tmaslon/Ammeter/Ammeter.pdf

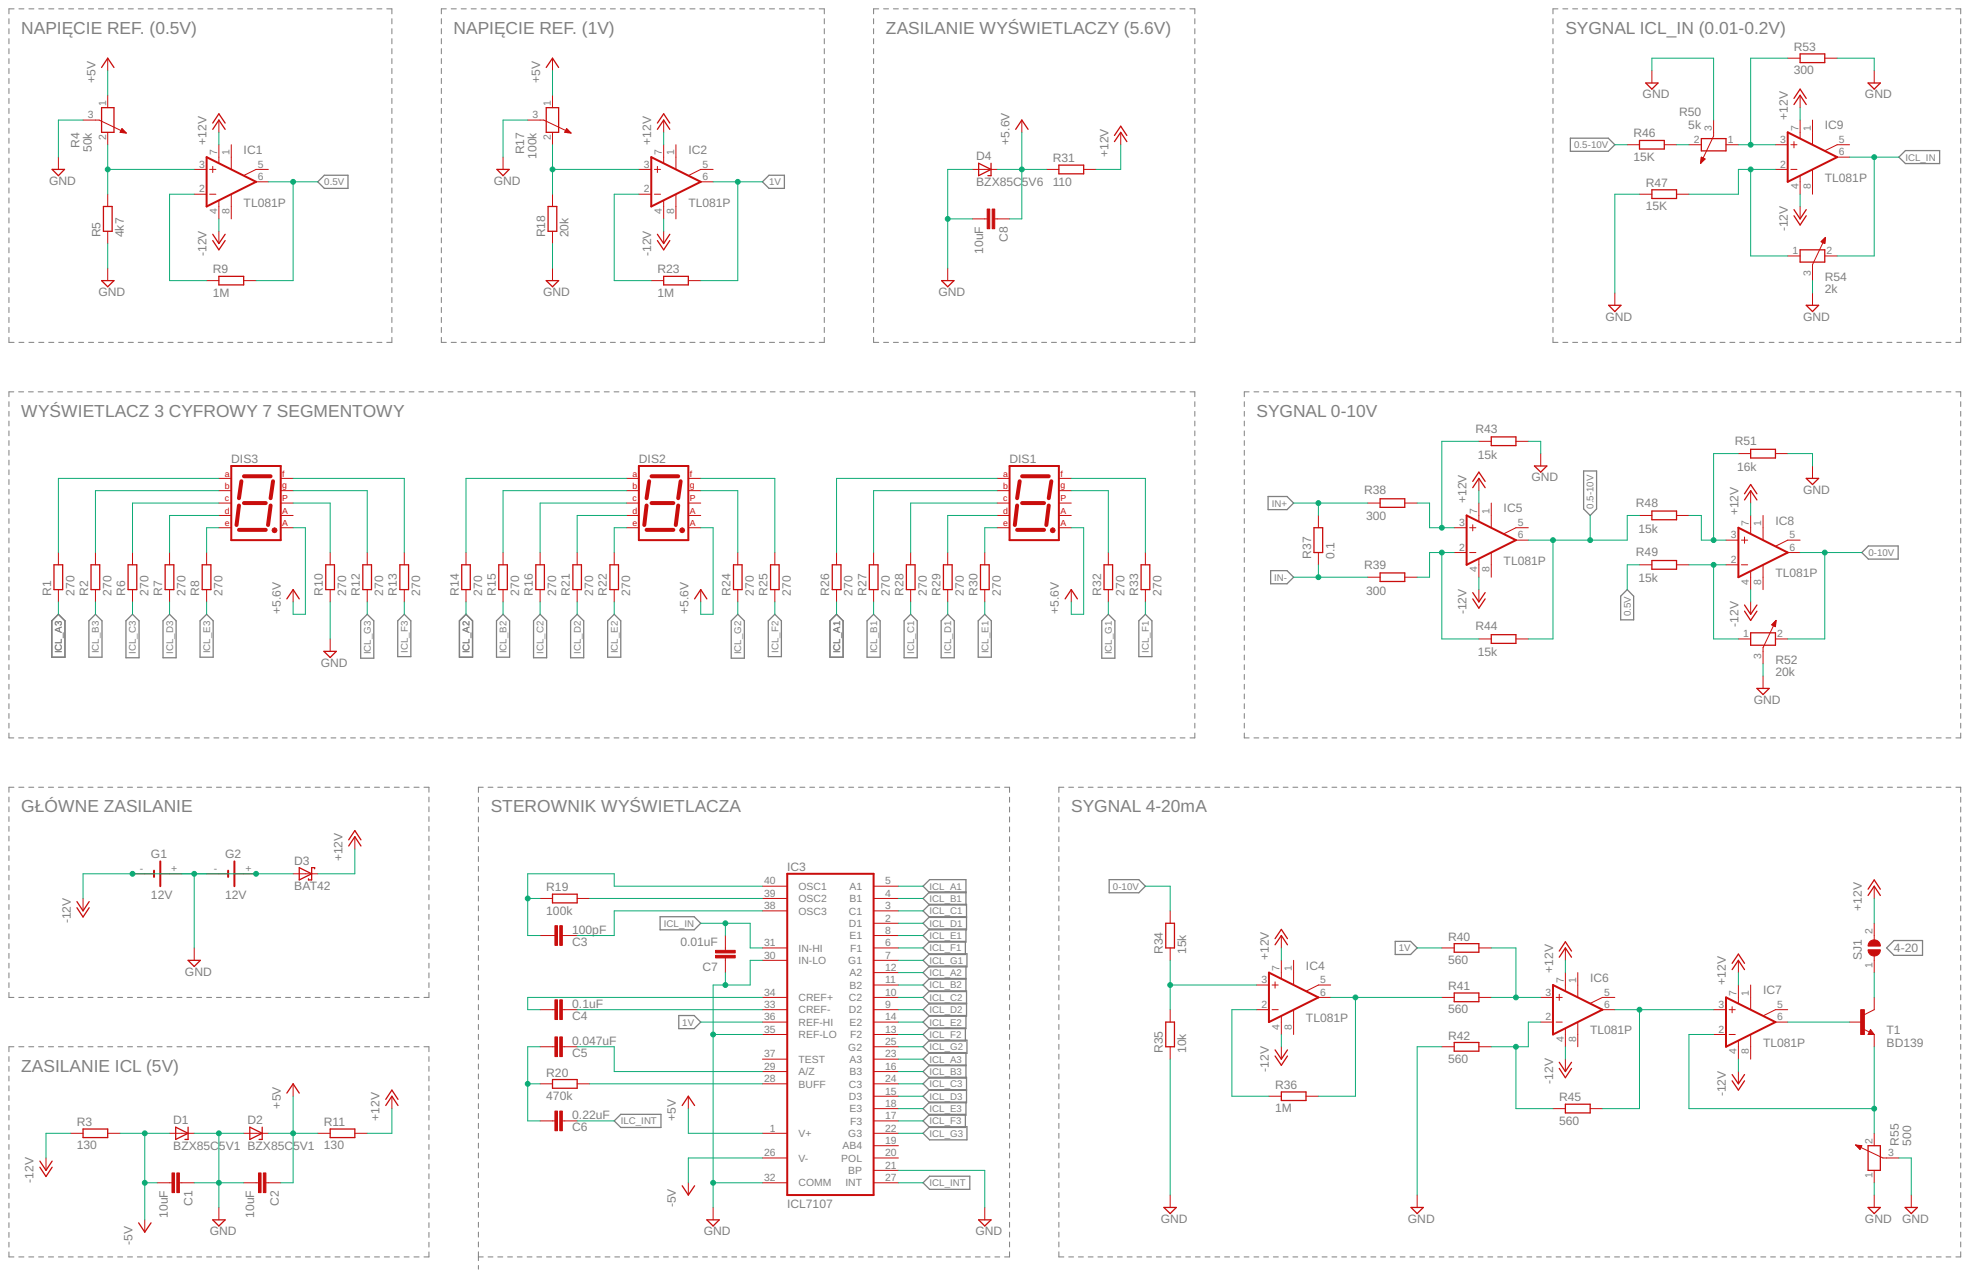
[picture p12: page 1]
