tmaslon/Ammeter/schemat.pdf

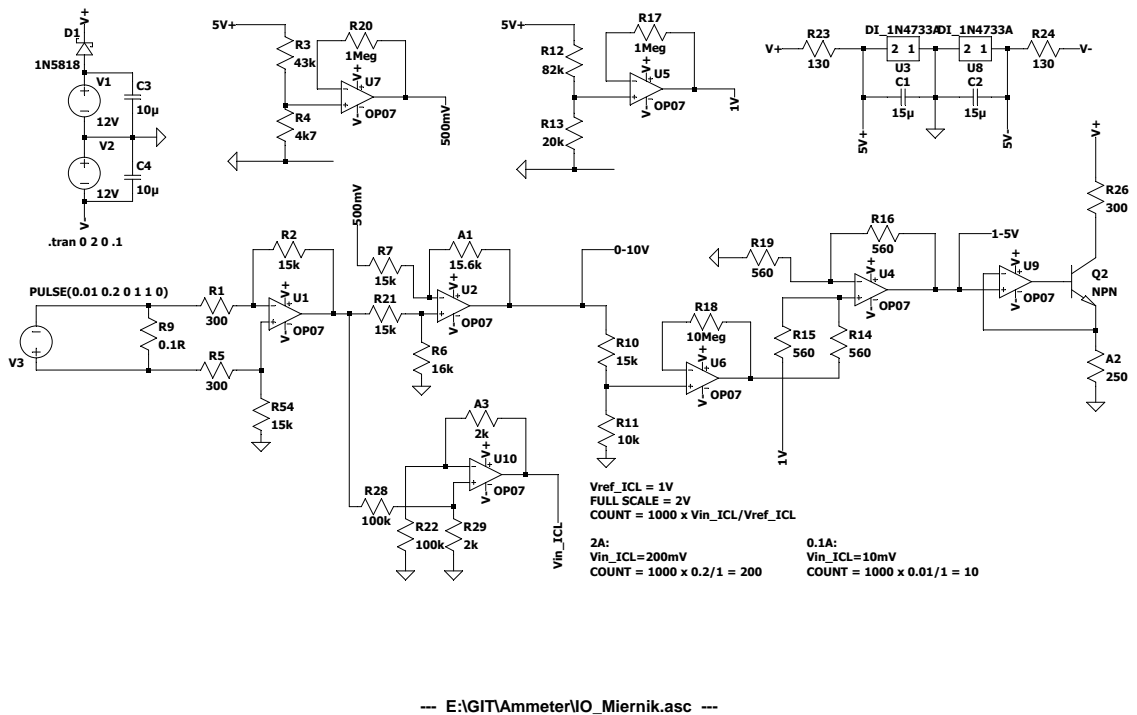
[picture p13: page 1]
