tmaslon/Ammeter/IO_Miernik.asc

A1: res; 15.6k
A2: res; 250
A3: res; 2k
C1: cap; 15µ
C2: cap; 15µ
C3: cap; 10µ
C4: cap; 10µ
D1: schottky; 1N5818
Q2: npn
R1: res; 300
R2: res; 15k
R3: res; 43k
R4: res; 4k7
R5: res; 300
R6: res; 16k
R7: res; 15k
R9: res; 0.1R
R10: res; 15k
R11: res; 10k
R12: res; 82k
R13: res; 20k
R14: res; 560
R15: res; 560
R16: res; 560
R17: res; 1Meg
R18: res; 10Meg
R19: res; 560
R20: res; 1Meg
R21: res; 15k
R22: res; 100k
R23: res; 130
R24: res; 130
R26: res; 300
R28: res; 100k
R29: res; 2k
R54: res; 15k
U1: OP07
U2: OP07
U3: DI_1N4733A
U4: OP07
U5: OP07
U6: OP07
U7: OP07
U8: DI_1N4733A
U9: OP07
U10: OP07
V1: voltage; 12V
V2: voltage; 12V
V3: voltage; PULSE(0.01 0.2 0 1 1 0)
Named nets: 0, V+, V-, 5V+, 0-10V, 1V, 1-5V, 500mV, 5V-, Vin_ICL
.tran 0 2 0 .1
Vref_ICL = 1V
FULL SCALE = 2V
COUNT = 1000 x Vin_ICL/Vref_ICL
 
2A:
Vin_ICL=200mV
COUNT = 1000 x 0.2/1 = 200
0.1A:
Vin_ICL=10mV
COUNT = 1000 x 0.01/1 = 10
