tmaslon/Ammeter/Ammeter.sch

## EAGLE design Ammeter.sch (2019-01-29)

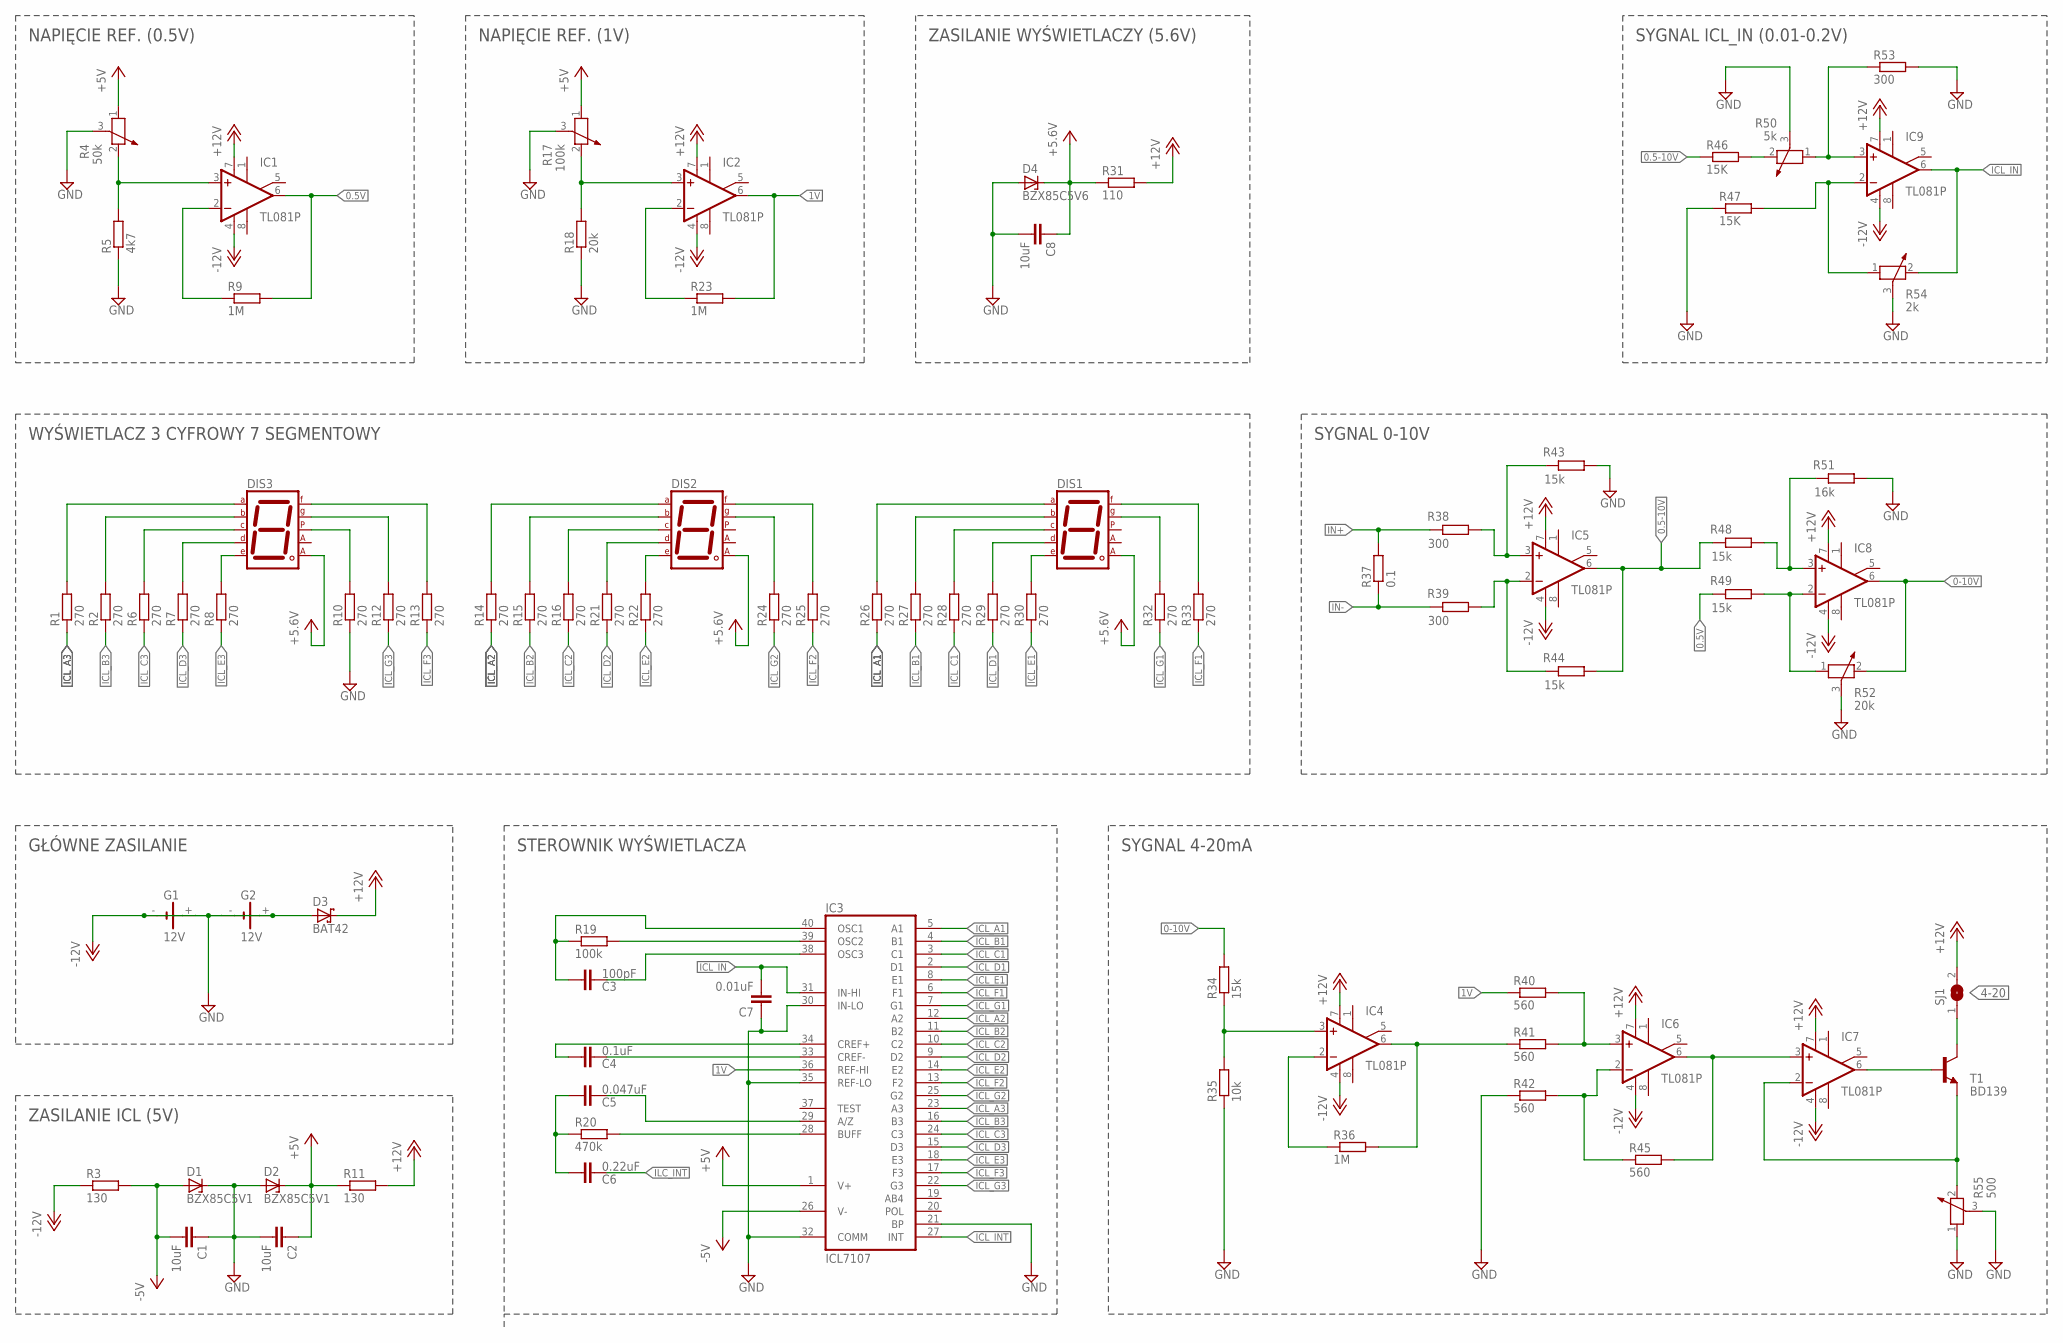
[picture p14: schematic Ammeter.sch]

Parts:
C1, C2, C8: 10uF; C025-024X044
C3: 100pF; C025-024X044
C4: 0.1uF; C025-024X044
C5: 0.047uF; C025-024X044
C6: 0.22uF; C025-024X044
C7: 0.01uF; C025-024X044
D1, D2: BZX85C5V1; DO41Z10
D3: BAT42; DO35-10
D4: BZX85C5V6; DO41Z10
DIS1, DIS2, DIS3: 7SEG-CA; 7SEG-13
G1, G2: 12V; CH291-1220LF
IC1, IC2, IC4, IC5, IC6, IC7, IC8, IC9: TL081P; DIL08
IC3: ICL7107; DIL40
R1, R2, R6, R7, R8, R10, R12, R13, R14, R15, R16, R21, R22, R24, R25, R26, R27, R28, R29, R30, R32, R33: 270; 0204/7
R3, R11: 130; 0204/7
R4: 50k; PT-SPIN
R5: 4k7; 0204/7
R9, R23, R36: 1M; 0204/7
R17: 100k; PT-SPIN
R18: 20k; 0204/7
R19: 100k; 0204/7
R20: 470k; 0204/7
R31: 110; 0204/7
R34, R43, R44, R48, R49: 15k; 0204/7
R35: 10k; 0204/7
R37: 0.1; 0204/7
R38, R39, R53: 300; 0204/7
R40, R41, R42, R45: 560; 0204/7
R46, R47: 15K; 0204/7
R50: 5k; PT-SPIN
R51: 16k; 0204/7
R52: 20k; PT-SPIN
R54: 2k; PT-SPIN
R55: 500; PT-SPIN
SJ1: SJ
T1: BD139; TO126

Connections:
0-10V: IC8.6 (OUT), R34.2, R52.2
0.5-10V: IC5.6 (OUT), R44.1, R46.1, R48.2
0.5V: IC1.6 (OUT), R9.2, R49.2
1V: IC2.6 (OUT), IC3.36 (REF-HI), R23.2, R40.1
4-20: SJ1.1, T1.2 (C)
+5V: C2.1, C8.1, D2.C, D4.C, DIS1.8 (CA2), DIS2.8 (CA2), DIS3.8 (CA2), IC3.1 (V+), R4.1, R11.1, R17.1, R31.1
+12V: D3.C, IC1.7 (V+), IC2.7 (V+), IC4.7 (V+), IC5.7 (V+), IC6.7 (V+), IC7.7 (V+), IC8.7 (V+), IC9.7 (V+), R11.2, R31.2, SJ1.2
-5V: C1.2, D1.A, IC3.26 (V-), R3.2
-12V: D3.A, G1.-, G2.+, IC1.4 (V-), IC2.4 (V-), IC4.4 (V-), IC5.4 (V-), IC6.4 (V-), IC7.4 (V-), IC8.4 (V-), IC9.4 (V-), R3.1
GND: C1.1, C2.2, C7.1, C8.2, D1.C, D2.A, D4.A, G1.+, G2.-, IC3.21 (BP), IC3.30 (IN-LO), IC3.32 (COMM), IC3.35 (REF-LO), R4.3, R5.1, R10.1, R17.3, R18.1, R35.1, R42.1, R43.1, R47.1, R50.3, R51.1, R52.3, R53.2, R54.3, R55.1, R55.3
ICL_A1: IC3.5 (A1), R26.1
ICL_A2: IC3.12 (A2), R14.1
ICL_A3: IC3.23 (A3), R1.1
ICL_B1: IC3.4 (B1), R27.1
ICL_B2: IC3.11 (B2), R15.1
ICL_B3: IC3.16 (B3), R2.1
ICL_C1: IC3.3 (C1), R28.1
ICL_C2: IC3.10 (C2), R16.1
ICL_C3: IC3.24 (C3), R6.1
ICL_D1: IC3.2 (D1), R29.1
ICL_D2: IC3.9 (D2), R21.1
ICL_D3: IC3.15 (D3), R7.1
ICL_E1: IC3.8 (E1), R30.1
ICL_E2: IC3.14 (E2), R22.1
ICL_E3: IC3.18 (E3), R8.1
ICL_F1: IC3.6 (F1), R33.1
ICL_F2: IC3.13 (F2), R25.1
ICL_F3: IC3.17 (F3), R13.1
ICL_G1: IC3.7 (G1), R32.1
ICL_G2: IC3.25 (G2), R24.1
ICL_G3: IC3.22 (G3), R12.1
ICL_IN: C7.2, IC3.31 (IN-HI), IC9.6 (OUT), R54.2
ICL_INT: IC3.27 (INT)
ILC_INT: C6.1
IN+: R37.2, R38.2
IN-: R37.1, R39.2
unnamed: C3.2, IC3.40 (OSC1), R19.1
unnamed: IC3.39 (OSC2), R19.2
unnamed: C3.1, IC3.38 (OSC3)
unnamed: C4.2, IC3.34 (CREF+)
unnamed: DIS3.5 (DP), R10.2
unnamed: C4.1, IC3.33 (CREF-)
unnamed: IC1.2 (-IN), R9.1
unnamed: C5.1, IC3.29 (A/Z)
unnamed: IC3.28 (BUFF), R20.2
unnamed: C5.2, C6.2, R20.1
unnamed: IC2.2 (-IN), R23.1
unnamed: IC1.3 (+IN), R4.2, R5.2
unnamed: IC2.3 (+IN), R17.2, R18.2
unnamed: IC5.3 (+IN), R38.1, R43.2
unnamed: IC5.2 (-IN), R39.1, R44.2
unnamed: IC8.2 (-IN), R49.1, R52.1
unnamed: IC4.3 (+IN), R34.1, R35.2
unnamed: IC8.3 (+IN), R48.1, R51.2
unnamed: IC4.2 (-IN), R36.1
unnamed: IC4.6 (OUT), R36.2, R41.1
unnamed: IC6.3 (+IN), R40.2, R41.2
unnamed: IC7.6 (OUT), T1.3 (B)
unnamed: IC6.2 (-IN), R42.2, R45.1
unnamed: IC6.6 (OUT), IC7.3 (+IN), R45.2
unnamed: IC7.2 (-IN), R55.2, T1.1 (E)
unnamed: DIS1.7 (A), R26.2
unnamed: DIS1.6 (B), R27.2
unnamed: DIS1.4 (C), R28.2
unnamed: DIS1.2 (D), R29.2
unnamed: DIS1.1 (E), R30.2
unnamed: DIS1.9 (F), R33.2
unnamed: DIS2.7 (A), R14.2
unnamed: DIS1.10 (G), R32.2
unnamed: DIS2.2 (D), R21.2
unnamed: DIS2.6 (B), R15.2
unnamed: DIS2.4 (C), R16.2
unnamed: DIS2.1 (E), R22.2
unnamed: DIS2.9 (F), R25.2
unnamed: DIS2.10 (G), R24.2
unnamed: DIS3.7 (A), R1.2
unnamed: DIS3.2 (D), R7.2
unnamed: DIS3.6 (B), R2.2
unnamed: DIS3.4 (C), R6.2
unnamed: DIS3.1 (E), R8.2
unnamed: DIS3.9 (F), R13.2
unnamed: DIS3.10 (G), R12.2
unnamed: R46.2, R50.2
unnamed: IC9.3 (+IN), R50.1, R53.1
unnamed: IC9.2 (-IN), R47.2, R54.1

Notes on the sheet:
GŁÓWNE ZASILANIE
ZASILANIE ICL (5V)
SYGNAL 0-10V
SYGNAL 4-20mA
STEROWNIK WYŚWIETLACZA
WYŚWIETLACZ 3 CYFROWY 7 SEGMENTOWY
SYGNAL ICL_IN (0.01-0.2V)
ZASILANIE WYŚWIETLACZY (5.6V)
NAPIĘCIE REF. (0.5V)
NAPIĘCIE REF. (1V)
