tmaslon/Ammeter/(commit log)

2019-01-17 Adding diode voltage regulator and transistor
2019-01-19 Updating resistors' values, adding Vin_ICL
2019-01-22 Adding EAGLE lib - work in progress
    [Ammeter.sch]
2019-01-22 Lib: adding 0-10V signal
    [Ammeter.sch]
2019-01-22 Lib: Adding 4-20mA signal
    [Ammeter.sch]
2019-01-23 Lib: added ICL pins labels and displays
    [Ammeter.sch]
2019-01-24 Added ICL_IN signal, renumbered parts
    [Ammeter.sch]
2019-01-26 Added separate power supply for displays, updating parts' values
    [Ammeter.sch]
2019-01-27 Renumbering parts
    [Ammeter.sch]
2019-01-29 fixed errors in schematic and added BOM
    [Ammeter.sch, BOM.csv]
2019-01-29 hotfix (incorrect label in schematic)
    [Ammeter.sch]
2019-01-29 Updated documentation: added tests results and attachments
2019-01-29 hotfix: updated R3 an R11 values
    [Ammeter.sch, BOM.csv]
